mileslucas/vampires-coronagraph/README.md

# vampires-coronagraph

**PI: Miles Lucas**

Designing coronagraphs for Subaru/VAMPIRES.

## Attribution

## Setup

Set up the environment using poetry

```
$ poetry install
```

## HCIPy Simulations

The
