mileslucas/vampires-coronagraph/paper/report.pdf

## Visible-light Lyot Coronagraph for SCExAO/VAMPIRES

Miles Lucasa,*, Michael Bottoma
, Olivier Guyonb,c, Julien Lozib

, and Barnaby Norrisd

a
Institute for Astronomy, Unviersity of Hawai’i, 640 N. Aohoku Pl., Hilo, HI 96720, USA bNational Observatory of Japan, Subaru Telescope, 650 N. Aohoku Pl., Hilo, HI 96720, USA cSteward Observatory, Unviersity of Arizona, 933 N. Cherry Ave., Tucson, AZ 85721, USA dSydney Institute for Astronomy, School of Physics, Physics Rd., University of Sydney, NSW 2006, Australia

ABSTRACT

Limit 250 words.

Keywords: Coronagraph, Optical, Visible, High-Contrast, Imaging, Exoplanets

### 1. INTRODUCTION

Coronagraphy is a well-established technique for imaging circumstellar regions by controlling the stellar diffraction pattern. In high-contrast imaging, coronagraphs are an important tool for increasing the sensitivity around the star, enabling the direct detection of exoplanets and circumstellar disks. Combined with adaptive optics (AO), a coronagraph can enable detections of sources many orders of magnitude fainter than their host stars (∼ 10⁻⁶ ).

### 2. METHODS

### 2.1 Designing the Coronagraph

We used the open-source python package HCIPy¹
for simulating our coronagraph design with Fourier optics. We defined our wavefronts on a rasterized image of the SCExAO pupil sampled on a 256x256 pixel grid. Initially, we do not introduce any wavefront errors. Using a Fraunhofer propagator with an F/28.4 focal ratio, we formed the intermediate focal plane, where the focal plane mask will be inserted. The focal plane masks are hard-edged circles, and were modeled using a circular apodizer with either 0% or 0.1% transmission. We designed four focal plane masks with radii of 36, 54, 90, and 126 mas, respectively. These radii correspond to ∼2, 3, 5, and 7 λ/D at 750 nm. The focal plane after the mask was propagated to the next pupil plane, where the Lyot stop will be inserted.
The Lyot stop was modeled using a series of circular and rectangular apodizers with 0% transmission. The stop design follows the shape of the SCExAO pupil with an undersized diameter and oversized obstructions. The outer diameter is 90% the clear aperture diameter, the inner obstruction is 45% the clear aperture diameter (the secondary obstruction is ∼31% the clear aperture diameter), the secondary support struts are 200% as wide, and the bad deformable mirror probes are 150% in size. The ratio of areas of the Lyot stop and the SCExAO pupil is 63.7%. This final wavefront was propagated to the detector focal plane, forming the post-coronagraphic point-spread function.

We repeated the above process for a series of wavelengths to approximate a broadband PSF. We summed the images produced with 10 wavefronts from 725 nm to 775 nm to mimic the “750-50” filter (750 nm central wavelength with 50 nm uniform bandpass). We chose this filter because it has the highest throughput. As an additional step, we generated many datasets with random tip and tilt errors sampled from a bivariate Gaussian with 10 mas RMS jitter to test the coronagraph’s resiliency to low-order wavefront errors.

We evaluated the performance and quality of our simulations from the radial profiles of the unobstructed PSF and the post-coronagraphic PSF.

Further author information: (Send correspondence to M.D.L.)
M.D.L.: E-mail: mdlucas@hawaii.edu

Figure 1. Simulated contrast and throughput curves for each mask size

### 2.2 Construction and Installation

We chose a metallic vapor deposition process (https://opto-line.com/) for both the focal plane masks and the Lyot stop. The patterns are deposited onto a glass substrate with micrometer-precision, giving us great flexibility and precision in our designs. One downside of this approach is that the glass focal plane mask will shift the focus since it is in a converging beam. In VAMPIRES, there is a custom optics mount in the focal plane with 8 mm x 8 mm slots, so we arranged for four masks to be diced from a single 30 mm optical flat (Edmund Optics #84-466), (https://www.edmundoptics.com/p/30mm-dia-4mm-thick-nir-i-coated-lambda10-fused-silica-window/27562/) making sure each segment was within the clear aperture. The focal plane mask patterns were deposited with chromium with thicknesses of 110 nm. The thickness was determined from the optical penetration depth for a desired transmission

sˆ(λ) = −

λ
4π˜k(λ)

ln I(λ)
I0(λ)

(1)

where ˆs is the thickness, λ is the wavelength (tested across the 600-800 nm range for VAMPIRES), ˜k is the extinction coefficient, and I/I0 is the relative intensity for transmitted light. For each of the four mask radii, we constructed a mask with 1e-8 transmission and 0.1% transmission, which corresponds to thicknesses of 300 nm and 110 nm of chromium, respectively.
The Lyot stop was deposited onto a 25 mm optical flat (Edmund Optics #84-465) (https://www.edmundoptics.com/p/25mm-dia-3mm-thick-nir-i-coated-lambda10-fused-silica-window/27561/) with no further processing. We designed the Lyot stop to be reflective for the purposes of alignment and low-order wavefront sensing from the rejected light. To this end, we constructed the stop with pure gold on its first surface for its high reflectivity (>90%) across the 600-800 nm wavelength range. Following the advice from our vendor, this gold layer was deposited on top of a layer of chromium which adheres better to the anti-reflection coating on our subtrates than gold. We used Equation 1 with a linear combination of 50% chromium and 50% gold to determine a combined thickness of 285 nm for 1e-8 transmission. The final thickness of the chromium and gold deposit was specified as 300 nm.

The focal plane masks and Lyot stop were installed on SCExAO in January, 2022. We decided to only install the four transmissive (0.1%) focal plane masks given the limited number of slots in the focal plane mount. The Lyot stop was accidentally mirrored with respect to the pupil and was not correctly scaled to the beam width. A new stop was designed and procured to address these issues and was deployed on SCExAO in February, 2022.

Figure 2. (a) the focal plane mask holder (b) the Lyot stop

### 2.3 Operation and Characterization

Figure 3. “Astrogrid” calibration speckles (a) on bench (b) on sky

### 3. RESULTS

### 3.1 Testbed results

Our first tests use the internal calibration source on SCExAO for determining the throughput and contrast of the coronagraph for each focal plane mask.

Figure 4. Contrast and throughput curves for each mask size

### 3.2 On-sky results

Figure 5. Contrast curve for 3λ/D mask in average seeing of HDXXXXXX

### 4. CONCLUSIONS

In this paper we have described the design, construction, and deployment of a visible-light Lyot coronagraph on SCExAO/VAMPIRES.

In the future, as wavefront control improves for SCExAO, we want to explore phase-based focal plane masks such as the four-quadrant phase mask (4QPM).² Phase-based masks offer improved contrast over amplitudebased designs like the classic Lyot style, but are highly sensitive to pointing errors and thus require fine tip-tilt control for effective use.³ We also are interested in exploring apodized Lyot stops for more precise attenuation of rejected light.

APPENDIX A. CODE AND DATA AVAILABILITY

The code used for simulating the coronagraph (subsection 2.1), reducing and analyzing testbed (subsection 3.1) and on-sky data (subsection 3.2), and for producing the figures in this paper are all available under an open-source license in a GitHub repository (mileslucas/vampires-coronagraph). (https://github.com/mileslucas/vampires-coronagraph) The CAD drawings for the focal plane masks and Lyot stops are also available in the online repository. Further requests or questions about code or data are welcomed.

ACKNOWLEDGMENTS

REFERENCES

[1] Por, E. H., Haffert, S. Y., Radhakrishnan, V. M., Doelman, D. S., van Kooten, M., and Bos, S. P., “High Contrast Imaging for Python (HCIPy): An open-source adaptive optics and coronagraph simulator,” 10703, 1070342 (July 2018).
[2] Rouan, D., Baudrand, J., Boccaletti, A., Baudoz, P., Mawet, D., and Riaud, P., “The Four Quadrant Phase Mask Coronagraph and its avatars,” Comptes Rendus Physique 8, 298–311 (Apr. 2007).
[3] Huby, E., Bottom, M., Femenia, B., Ngo, H., Mawet, D., Serabyn, E., and Absil, O., “On-sky performance of the QACITS pointing control technique with the Keck/NIRC2 vortex coronagraph,” Astronomy and Astrophysics 600, A46 (Apr. 2017).
