mileslucas/vampires-coronagraph/paper/figures/astrogrid_psf.pdf

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

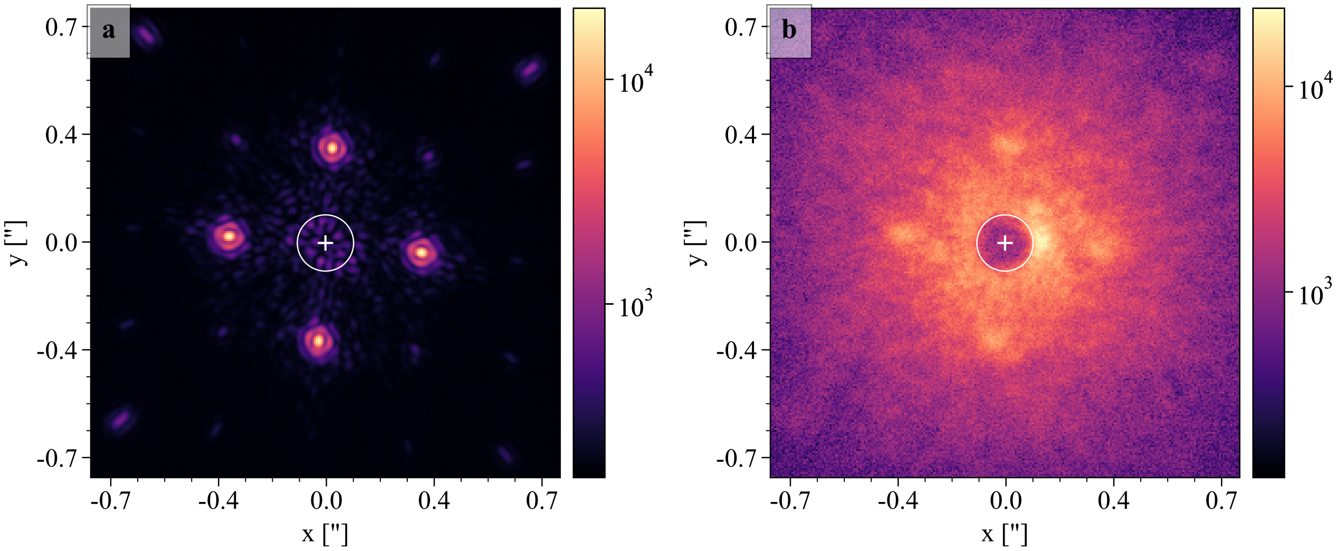
[picture p3: page 1]
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
