mileslucas/vampires-coronagraph/(list of files, cad)

Other CAD files:
drawings/lyot_stop_mirrored.dwg
drawings/focal_plane_mask.dwg
drawings/lyot_stop.dwg
drawings/2020_SCExAO_pupil.dwg
