mileslucas/vampires-coronagraph/paper/figures/VAMPIRES_bench.pdf

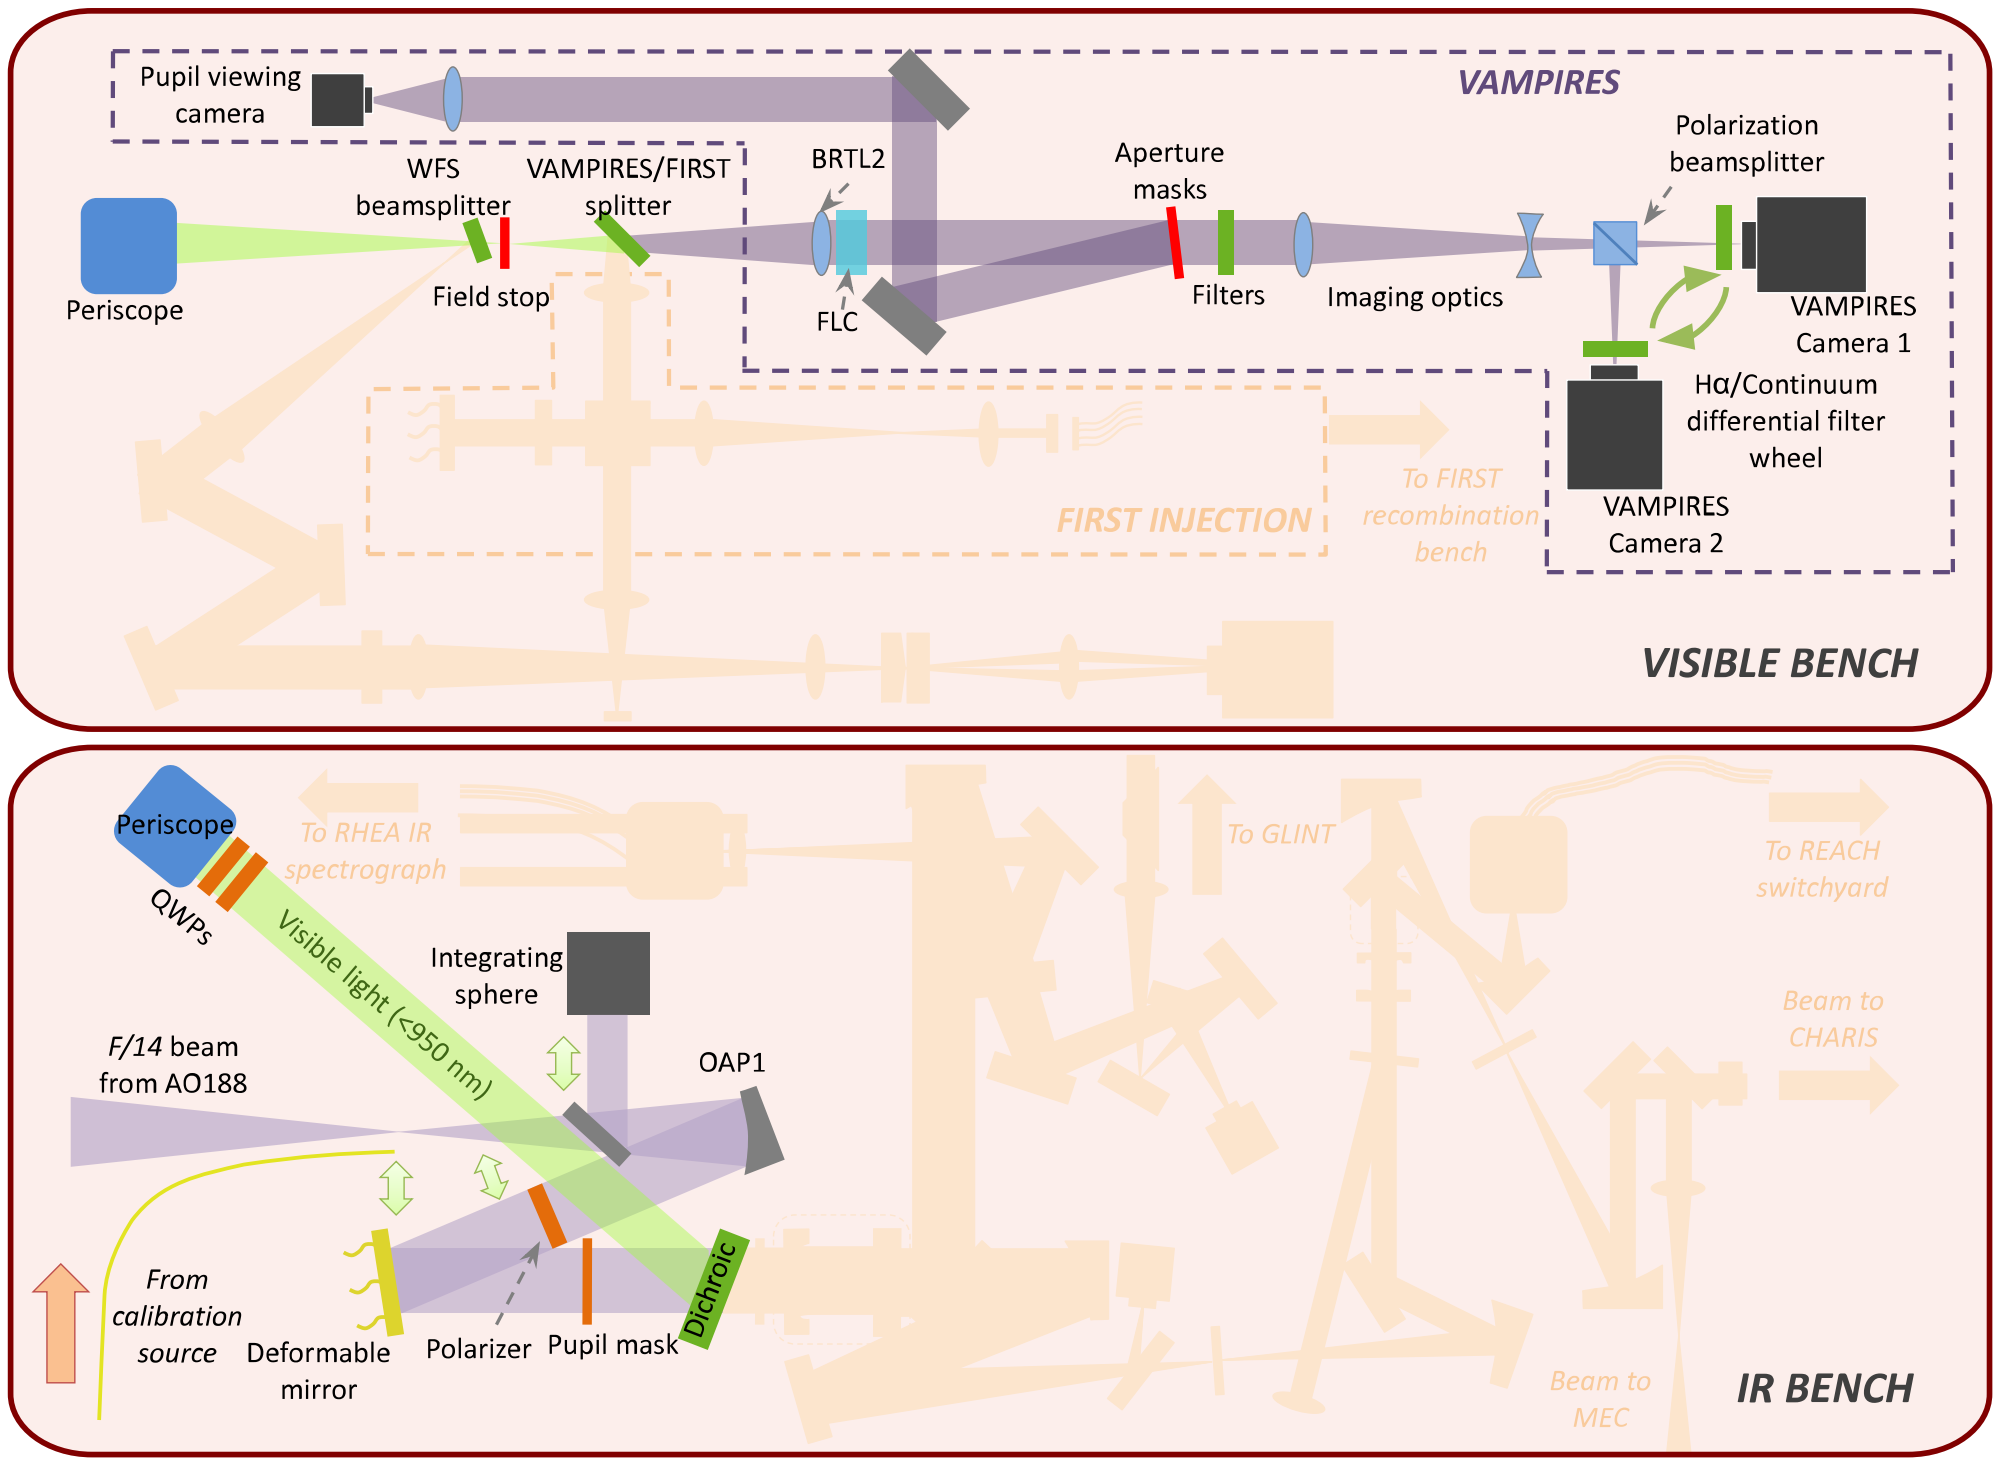
[picture p4: page 1]
