mileslucas/vampires-coronagraph/paper/figures/HIP56083_20220512_curves.pdf

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

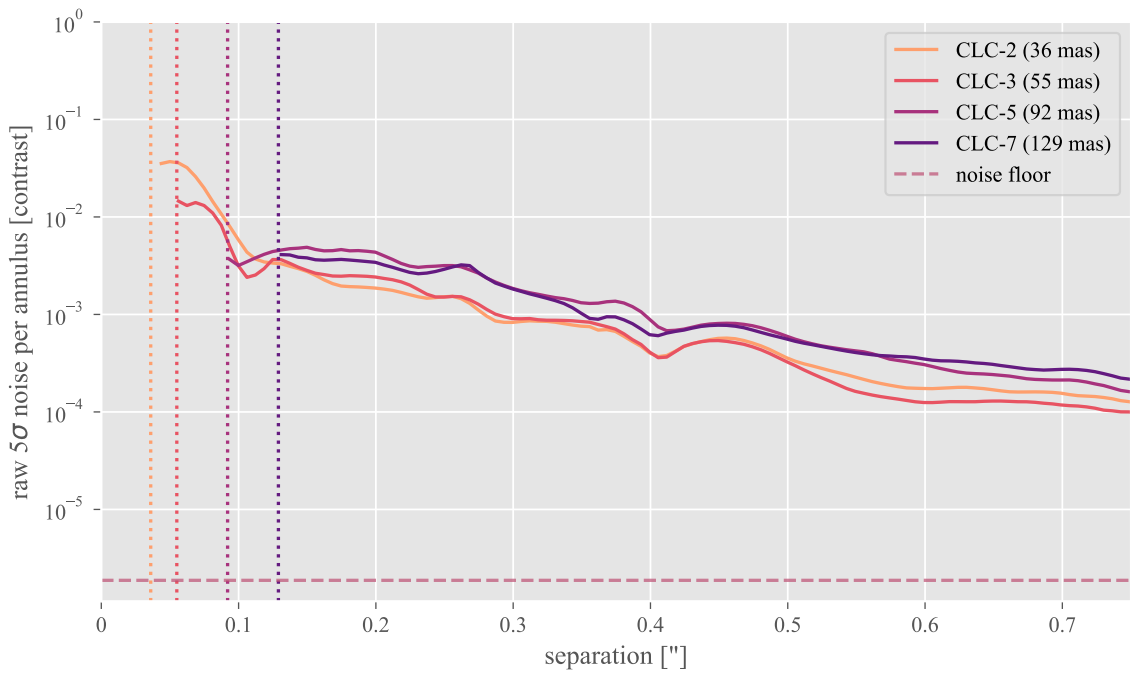
[picture p5: page 1]
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
