mileslucas/vampires-coronagraph/paper/figures/throughput_curves.pdf

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

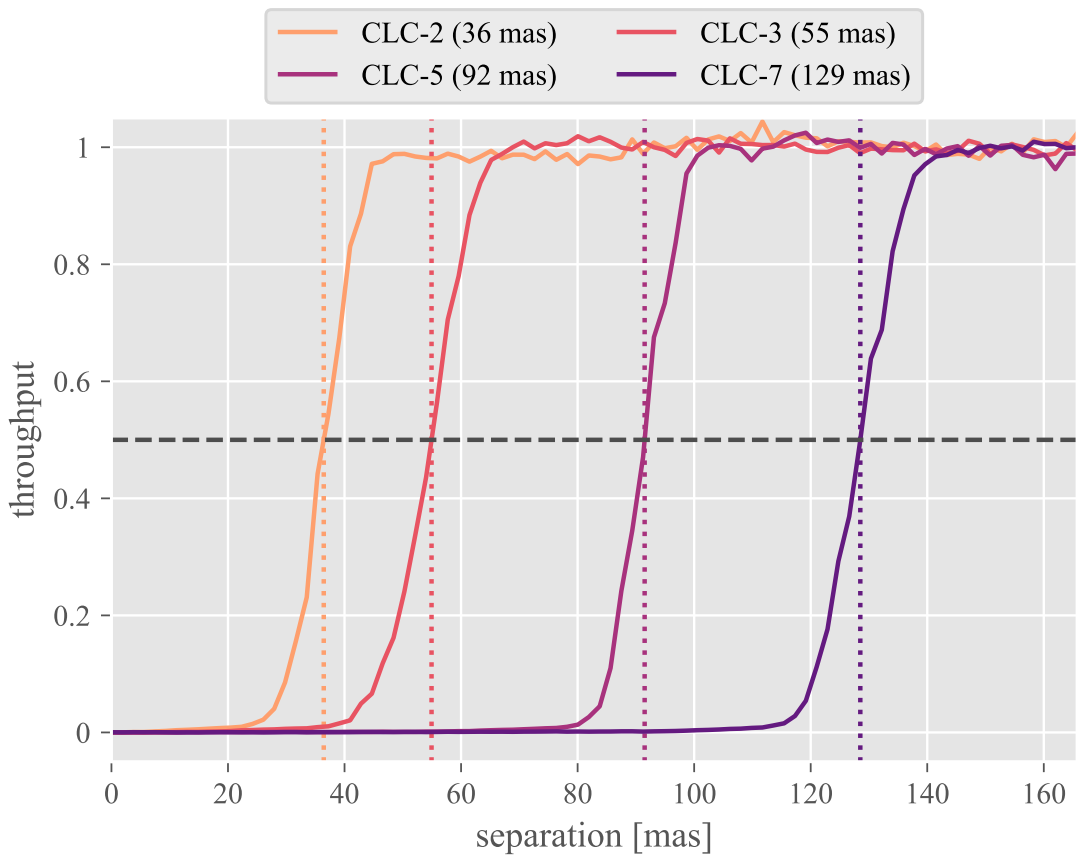
[picture p9: page 1]
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
