mileslucas/vampires-coronagraph/(commit log)

2021-08-09 fix coronagraph prop errors
2021-10-07 add key drawings
    [2020_SCExAO_pupil.dwg, focal_plane_mask.dwg, lyot_stop.dwg]
2021-10-07 update drawings
    [focal_plane_mask.dwg, lyot_stop.dwg]
2022-03-30 add fixed Lyot stop drawing
    [lyot_stop_mirrored.dwg]
2022-05-10 switch to conference proceedings template
